Ainsley-uu/Multi-frequency_Point_Synthetic_Analog_Signal_Data_Transmission_System/仿真电路.pdf

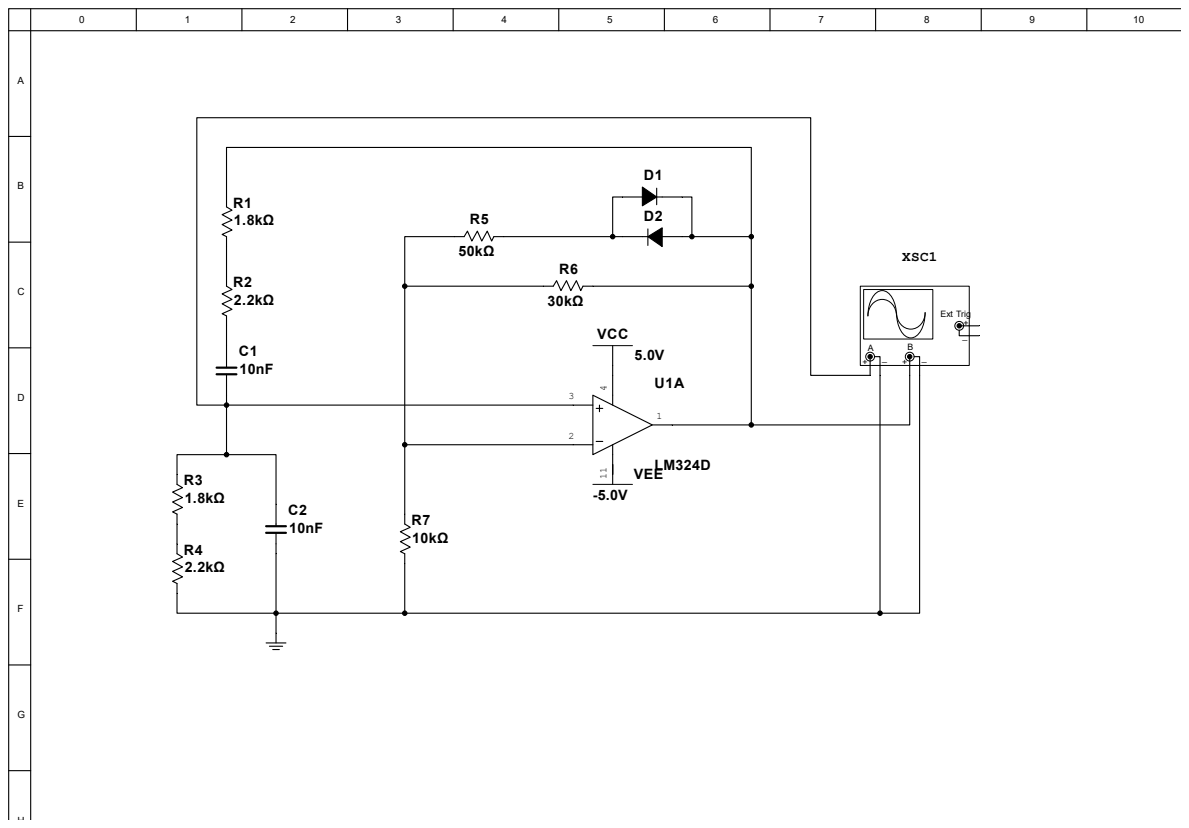
[picture p11: page 1]

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
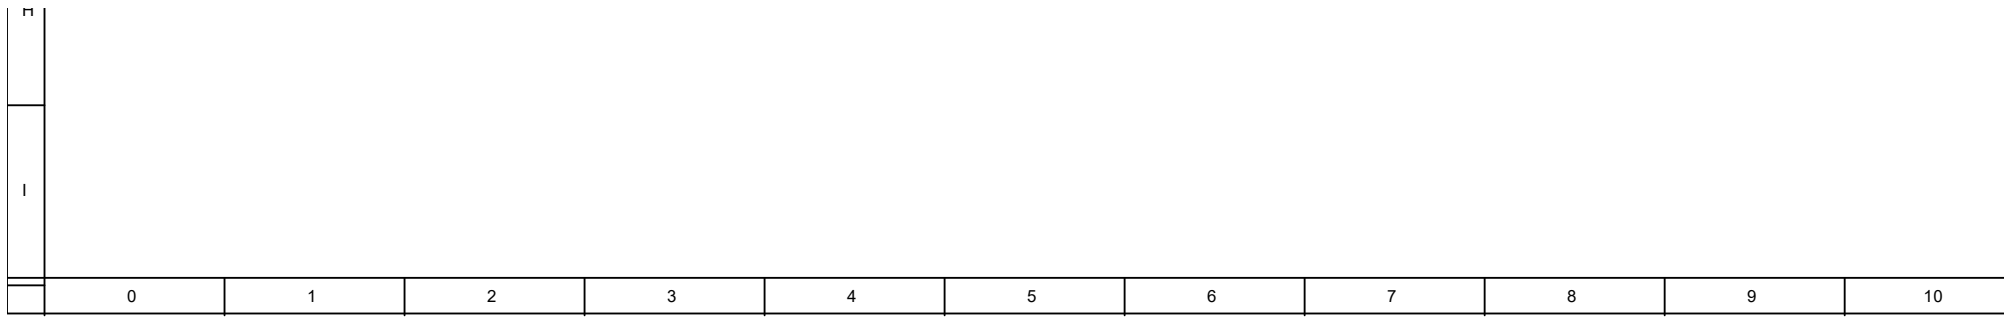
[picture p12: figure]

11

I
