Ainsley-uu/Multi-frequency_Point_Synthetic_Analog_Signal_Data_Transmission_System/校赛实验报告/3XP[ED7F(CNPF]U3WH)]J{J.jpg

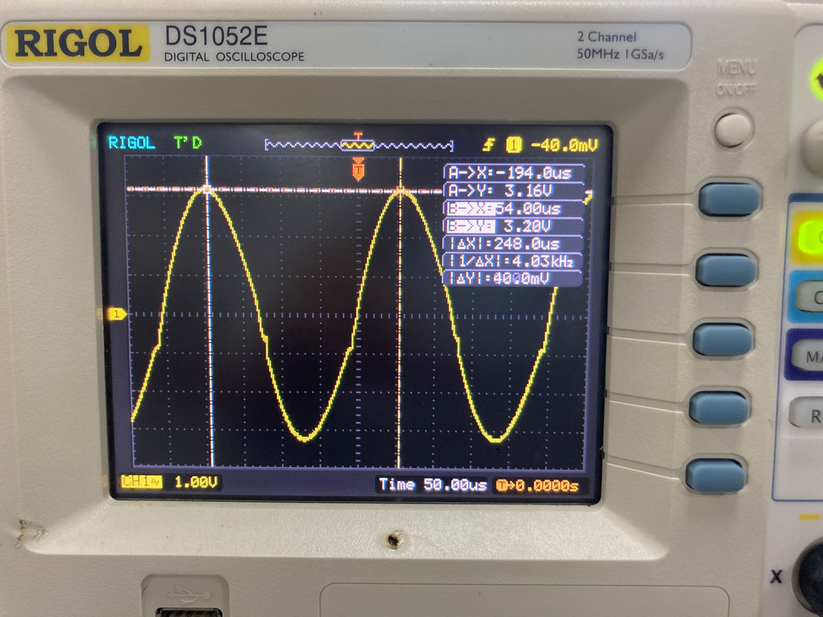
校赛实验报告/3XP[ED7F(CNPF]U3WH)]J{J.jpg
