Ainsley-uu/Multi-frequency_Point_Synthetic_Analog_Signal_Data_Transmission_System/校赛实验报告/16Hz.jpg

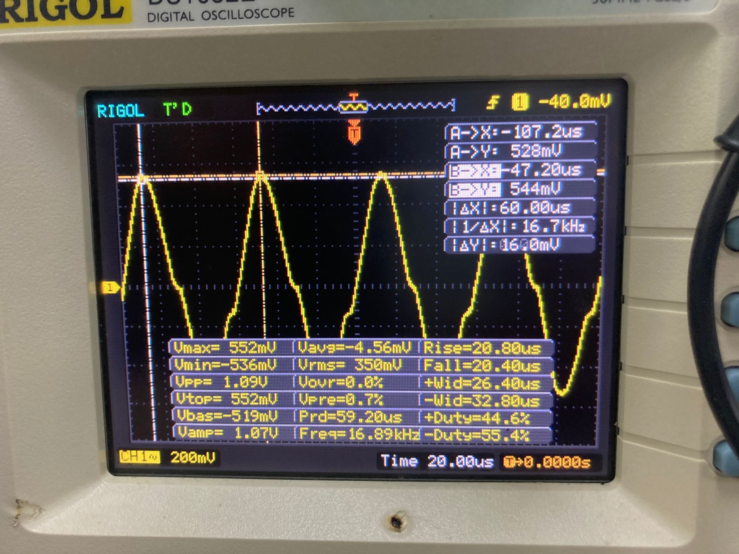
校赛实验报告/16Hz.jpg
