Ainsley-uu/Multi-frequency_Point_Synthetic_Analog_Signal_Data_Transmission_System/校赛实验报告/]$3QT$V%3ZTQ8RN8V$BH90K.jpg

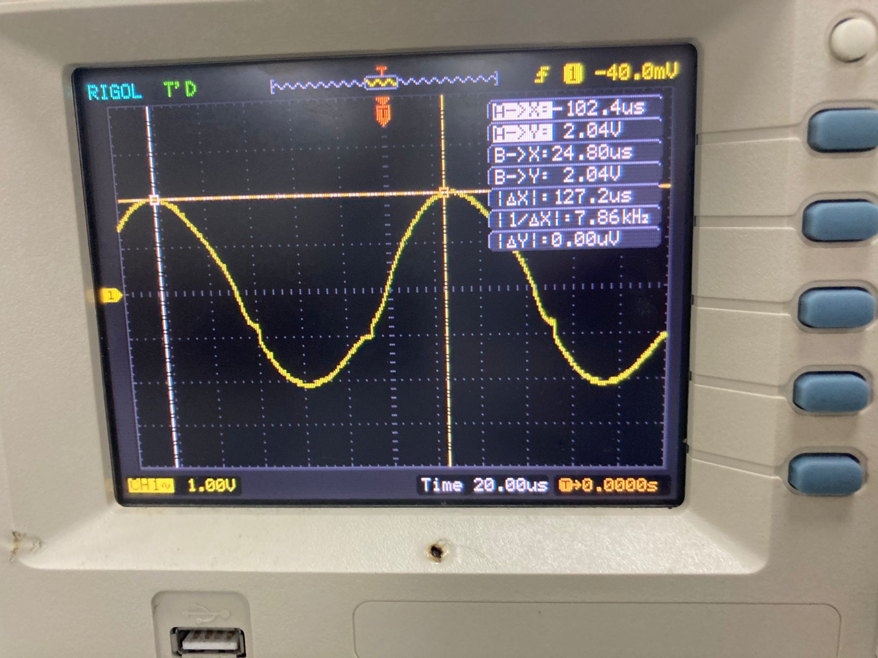
校赛实验报告/]$3QT$V%3ZTQ8RN8V$BH90K.jpg
