Ainsley-uu/Multi-frequency_Point_Synthetic_Analog_Signal_Data_Transmission_System/校赛实验报告/流程图 (2).png

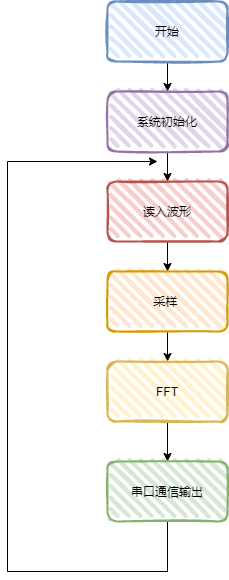
校赛实验报告/流程图 (2).png
