Ainsley-uu/Multi-frequency_Point_Synthetic_Analog_Signal_Data_Transmission_System/(list of files, drawings)

Other design files:
2021年浙江大学电子设计竞赛题/4KHz.ms13
