Ainsley-uu/Multi-frequency_Point_Synthetic_Analog_Signal_Data_Transmission_System/src/time.c

#include "time.h"
#include "led.h"

/*******************************************************************************
* 函 数 名         : TIM4_Init
* 函数功能		   : TIM4初始化函数
* 输    入         : per:重装载值
					 psc:分频系数
* 输    出         : 无
*******************************************************************************/
void TIM4_Init(u16 per,u16 psc)
{
	TIM_TimeBaseInitTypeDef TIM_TimeBaseInitStructure;
	NVIC_InitTypeDef NVIC_InitStructure;
	
	RCC_APB1PeriphClockCmd(RCC_APB1Periph_TIM4,ENABLE);//使能TIM4时钟
	
	TIM_TimeBaseInitStructure.TIM_Period=per;   //自动装载值
	TIM_TimeBaseInitStructure.TIM_Prescaler=psc; //分频系数
	TIM_TimeBaseInitStructure.TIM_ClockDivision=TIM_CKD_DIV1;
	TIM_TimeBaseInitStructure.TIM_CounterMode=TIM_CounterMode_Up; //设置向上计数模式
	TIM_TimeBaseInit(TIM4,&TIM_TimeBaseInitStructure);
	
	TIM_ITConfig(TIM4,TIM_IT_Update,ENABLE); //开启定时器中断
	TIM_ClearITPendingBit(TIM4,TIM_IT_Update);
	
	NVIC_InitStructure.NVIC_IRQChannel = TIM4_IRQn;//定时器中断通道
	NVIC_InitStructure.NVIC_IRQChannelPreemptionPriority=2;//抢占优先级
	NVIC_InitStructure.NVIC_IRQChannelSubPriority =3;		//子优先级
	NVIC_InitStructure.NVIC_IRQChannelCmd = ENABLE;			//IRQ通道使能
	NVIC_Init(&NVIC_InitStructure);	
	
	TIM_Cmd(TIM4,ENABLE); //使能定时器	
}
